EmuTM/LegoRCHub/Model/PCB_Lego_Frame_05x07.SLDPRT

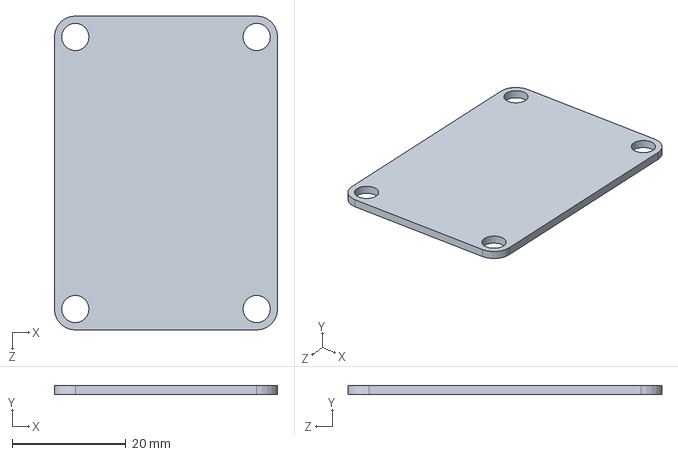
[picture p1: CAD file, 2024-12-19]
Model/PCB_Lego_Frame_05x07.SLDPRT
39.3 x 1.60 x 55.2 mm
