EmuTM/LegoRCHub/PCB/LegoRCHub_10ch/LegoRCHub_10ch.kicad_pcb

## KiCad design PCB/LegoRCHub_10ch/LegoRCHub_10ch.kicad_pcb (2026-02-22)

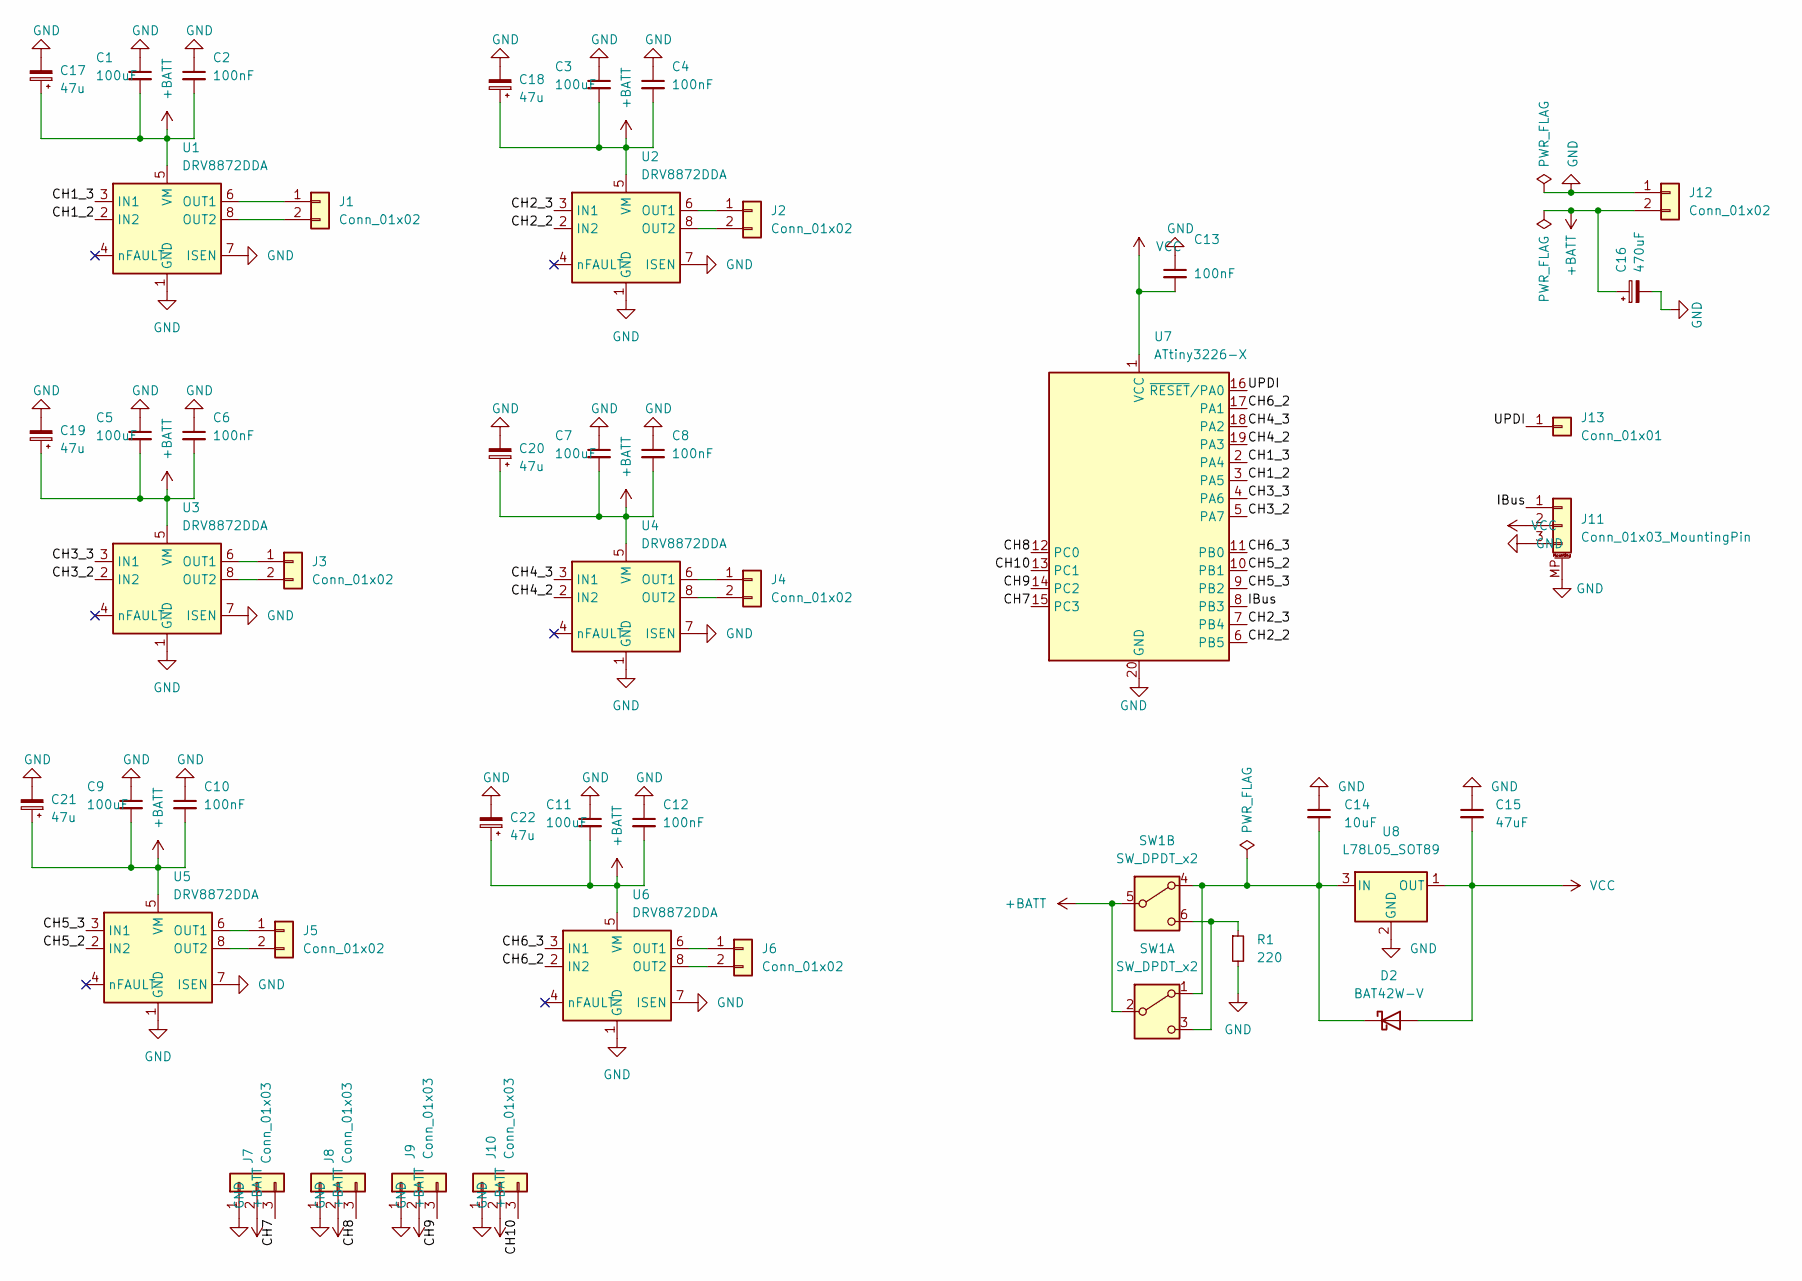
[picture p2: schematic LegoRCHub_10ch.kicad_sch, Lego RC Hub 10ch v7]

Parts:
C1, C3, C5, C7, C9, C11: 100uF; C_1206_3216Metric_Pad1.33x1.80mm_HandSolder
C2, C4, C6, C8, C10, C12: 100nF; C_0805_2012Metric_Pad1.18x1.45mm_HandSolder
C13: 100nF; C_1206_3216Metric_Pad1.33x1.80mm_HandSolder
C14: 10uF; C_0805_2012Metric_Pad1.18x1.45mm_HandSolder
C15: 47uF; C_0805_2012Metric_Pad1.18x1.45mm_HandSolder
C16: 470uF; CP_Elec_8x10.5
C17, C18, C19, C20, C21, C22: 47u; CP_Elec_5x5.4
D2: BAT42W-V; D_SOD-123
J1, J2, J3, J4, J5, J6: Conn_01x02; Molex_KK-254_AE-6410-02A_1x02_P2.54mm_Vertical
J7, J8, J9, J10: Conn_01x03; PinHeader_1x03_P2.54mm_Vertical
J11: Conn_01x03_MountingPin; JST_SH_BM03B-SRSS-TB_1x03-1MP_P1.00mm_Vertical
J12: Conn_01x02; AMASS_XT30U-M_1x02_P5.0mm_Vertical
J13: Conn_01x01; SolderWirePad_1x01_SMD_1x2mm
R1: 220; R_0805_2012Metric_Pad1.20x1.40mm_HandSolder
SW1: SW_DPDT_x2
U1, U2, U3, U4, U5, U6: DRV8872DDA; Texas_HTSOP-8-1EP_3.9x4.9mm_P1.27mm_EP2.95x4.9mm_Mask2.4x3.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
U7: ATtiny3226-X; SSOP-20_5.3x7.2mm_P0.65mm
U8: L78L05_SOT89; SOT-89-3

Connections:
+BATT: C1.2, C2.2, C3.2, C4.2, C5.2, C6.2, C7.2, C8.2, C9.2, C10.2, C11.2, C12.2, C16.1, C17.1, C18.1, C19.1, C20.1, C21.1, C22.1, J7.2, J8.2, J9.2, J10.2, J12.2, SW1.2 (B), SW1.5 (B), U1.5 (VM), U2.5 (VM), U3.5 (VM), U4.5 (VM), U5.5 (VM), U6.5 (VM)
/CH1_2: U1.2 (IN2), U7.3 (PA5)
/CH1_3: U1.3 (IN1), U7.2 (PA4)
/CH2_2: U2.2 (IN2), U7.6 (PB5)
/CH2_3: U2.3 (IN1), U7.7 (PB4)
/CH3_2: U3.2 (IN2), U7.5 (PA7)
/CH3_3: U3.3 (IN1), U7.4 (PA6)
/CH4_2: U4.2 (IN2), U7.19 (PA3)
/CH4_3: U4.3 (IN1), U7.18 (PA2)
/CH5_2: U5.2 (IN2), U7.10 (PB1)
/CH5_3: U5.3 (IN1), U7.9 (PB2)
/CH6_2: U6.2 (IN2), U7.17 (PA1)
/CH6_3: U6.3 (IN1), U7.11 (PB0)
/CH7: J7.3, U7.15 (PC3)
/CH8: J8.3, U7.12 (PC0)
/CH9: J9.3, U7.14 (PC2)
/CH10: J10.3, U7.13 (PC1)
/IBus: J11.1, U7.8 (PB3)
/UPDI: J13.1, U7.16 (~RESET/PA0)
GND: C1.1, C2.1, C3.1, C4.1, C5.1, C6.1, C7.1, C8.1, C9.1, C10.1, C11.1, C12.1, C13.1, C14.1, C15.1, C16.2, C17.2, C18.2, C19.2, C20.2, C21.2, C22.2, J7.1, J8.1, J9.1, J10.1, J11.3, J11.MP (MountPin), J12.1, R1.2, U1.1 (GND), U1.7 (ISEN), U1.9 (GND), U2.1 (GND), U2.7 (ISEN), U2.9 (GND), U3.1 (GND), U3.7 (ISEN), U3.9 (GND), U4.1 (GND), U4.7 (ISEN), U4.9 (GND), U5.1 (GND), U5.7 (ISEN), U5.9 (GND), U6.1 (GND), U6.7 (ISEN), U6.9 (GND), U7.20 (GND), U8.2 (GND)
unnamed: C14.2, D2.1 (K), SW1.1 (A), SW1.4 (A), U8.3 (IN)
unnamed: J1.1, U1.6 (OUT1)
unnamed: J1.2, U1.8 (OUT2)
unnamed: J2.1, U2.6 (OUT1)
unnamed: J2.2, U2.8 (OUT2)
unnamed: J3.1, U3.6 (OUT1)
unnamed: J3.2, U3.8 (OUT2)
unnamed: J4.1, U4.6 (OUT1)
unnamed: J4.2, U4.8 (OUT2)
unnamed: J5.1, U5.6 (OUT1)
unnamed: J5.2, U5.8 (OUT2)
unnamed: J6.1, U6.6 (OUT1)
unnamed: J6.2, U6.8 (OUT2)
unnamed: R1.1, SW1.3 (C), SW1.6 (C)
VCC: C13.2, C15.2, D2.2 (A), J11.2, U7.1 (VCC), U8.1 (OUT)

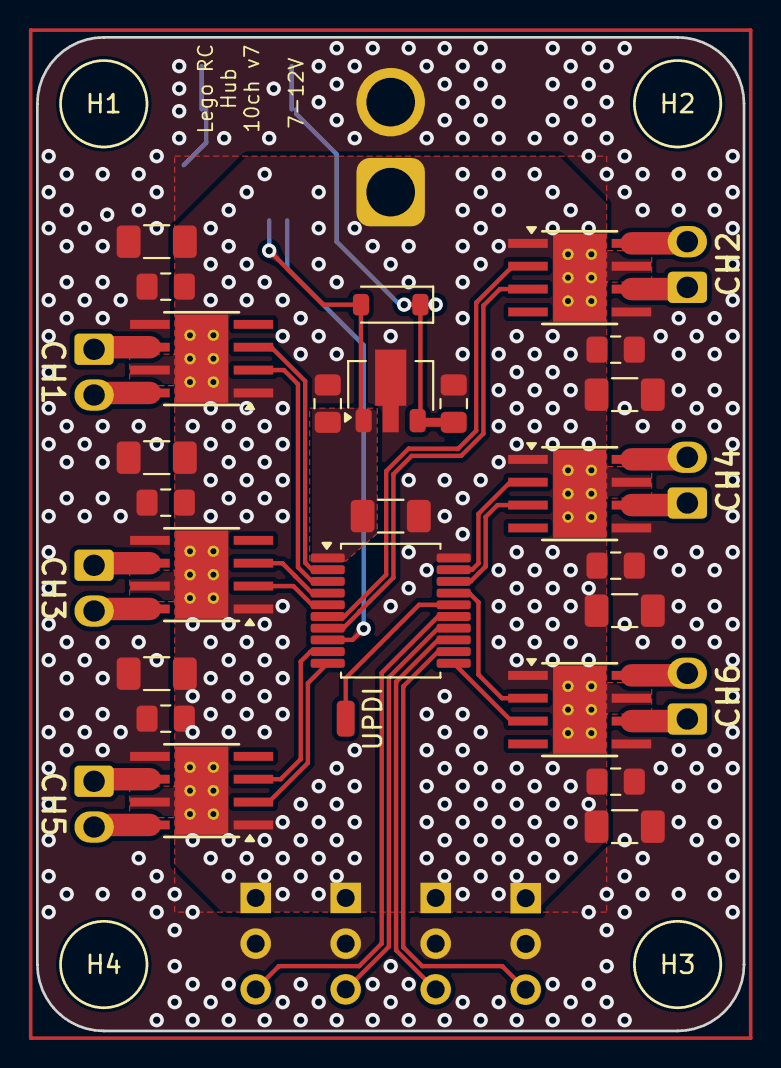
[picture p3: board LegoRCHub_10ch.kicad_pcb from above]

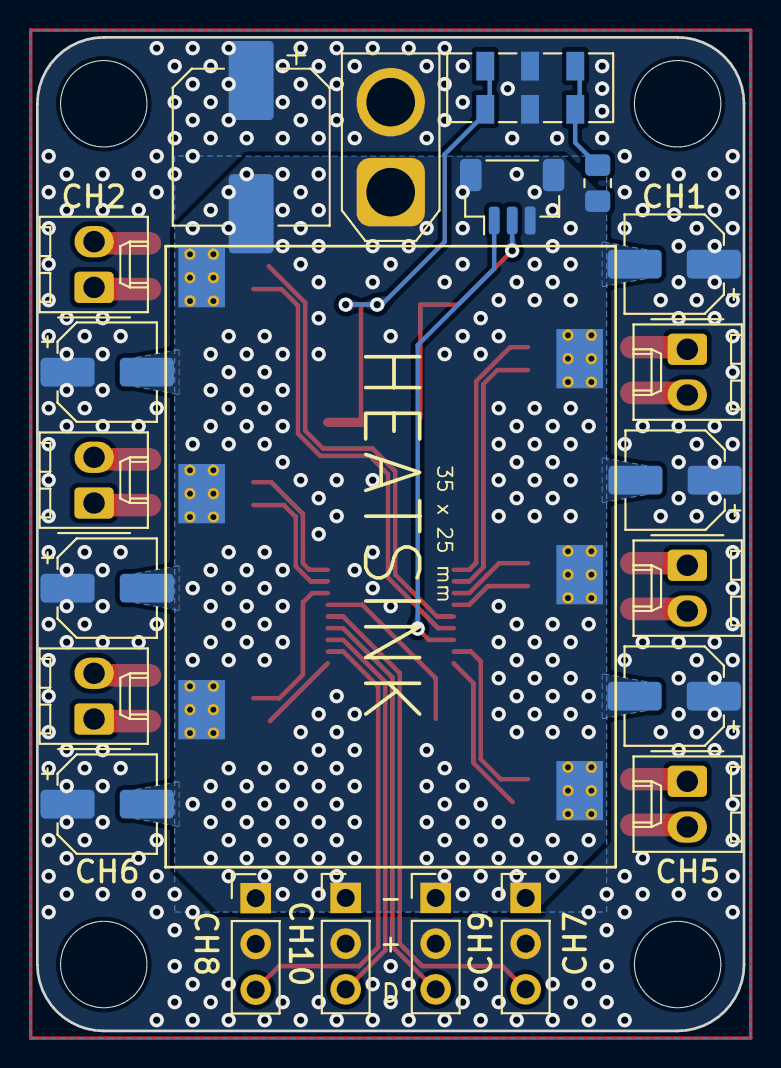
[picture p4: board LegoRCHub_10ch.kicad_pcb from below]

Board: 2 copper layers, 39.3 x 55.2 mm, 50 parts (21 on the bottom side), 35 nets.

Other parts of the board:
H1, H2, H3, H4: MountingHole; MountingHole_4.8mm_Lego
