EmuTM/LegoRCHub/(commit log)

2024-12-19 Added Models together with first model: PCB model for Lego Frame 5x7
    [PCB_Lego_Frame_05x07.SLDPRT]
2024-12-19 Added LegoRCHub_8ch project (KiCad)
    [LegoRCHub_8ch.kicad_pcb, LegoRCHub_8ch.kicad_sch]
2024-12-19 Updated PCB/.gitignore so it ignores ".kicad_prl" files (stores current user settings)
2024-12-19 LegoRCHub_8ch: added schematic
    [LegoRCHub_8ch.kicad_sch]
2024-12-19 PCB: added "CustomFootprints" together with Lego mounting hole (4.8mm)
2024-12-19 LegoRCHub_8ch: working on pcb design...
    [LegoRCHub_8ch.kicad_pcb, LegoRCHub_8ch.kicad_sch]
2024-12-20 LegoRCHub_8ch: finished PCB (beta 1)
    [LegoRCHub_8ch.kicad_pcb, LegoRCHub_8ch.kicad_sch]
2024-12-22 LegoRCHub_8ch: finished PCB (beta 2)
    [LegoRCHub_8ch.kicad_pcb, LegoRCHub_8ch.kicad_sch]
2024-12-22 LegoRCHub_8ch: finished PCB (beta 3)
    [LegoRCHub_8ch.kicad_pcb]
2024-12-23 LegoRCHub_8ch_ServoVoltageConversion: working on pcb design...
    [LegoRCHub_8ch.kicad_pcb]
2024-12-29 LegoRCHub_8ch: finished PCB (beta 4)
    [LegoRCHub_8ch.kicad_pcb, LegoRCHub_8ch.kicad_sch]
2024-12-31 LegoRCHub_8ch: finished PCB (beta 5)
    [LegoRCHub_8ch.kicad_pcb, LegoRCHub_8ch.kicad_sch]
2025-01-02 LegoRCHub_8ch: finished PCB (beta 6)
    [LegoRCHub_8ch.kicad_pcb]
2025-01-02 LegoRCHub_8ch: beta 6: simplified design with 4/4 layout
    [LegoRCHub_8ch.kicad_pcb, LegoRCHub_8ch.kicad_sch]
2025-01-02 LegoRCHub_8ch: beta 7
    [LegoRCHub_8ch.kicad_pcb]
2025-01-04 LegoRCHub_8ch: beta 8 (layout somewhat finished)
    [LegoRCHub_8ch.kicad_pcb, LegoRCHub_8ch.kicad_sch]
2025-01-04 Added project LegoRCHub_10ch: (beta 1)
    [LegoRCHub_10ch.kicad_pcb, LegoRCHub_10ch.kicad_sch]
2025-01-17 Added project LegoRCHub_10ch: (beta 2): changed pins to screw terminals
    [LegoRCHub_10ch.kicad_pcb, LegoRCHub_10ch.kicad_sch]
2025-01-21 LegoRCHub_10ch: ...
    Revert "LegoRCHub_10ch: ..."
    This reverts commit a8209f8826470efcec7313ecef0b47345458ad62.
    [LegoRCHub_10ch.kicad_pcb, LegoRCHub_10ch.kicad_sch]
2025-01-22 LegoRCHub_10ch: ...
    [LegoRCHub_10ch.kicad_pcb, LegoRCHub_10ch.kicad_sch]
2025-01-22 LegoRCHub_10ch: improved design - beta 1
    [LegoRCHub_10ch.kicad_pcb, LegoRCHub_10ch.kicad_sch]
2025-01-23 LegoRCHub_10ch: drv8872s motor traces width decreased to allow for a width increase on isen pin
    [LegoRCHub_10ch.kicad_pcb]
2025-01-23 LegoRCHub_10ch: improved layout...
    [LegoRCHub_10ch.kicad_pcb]
2025-01-24 LegoRCHub_10ch: improved layout: beta-2
    [LegoRCHub_10ch.kicad_pcb]
2025-01-24 LegoRCHub_10ch: improved layout: beta-3
    [LegoRCHub_10ch.kicad_pcb, LegoRCHub_10ch.kicad_sch]
2025-01-25 SW ATTiny3226_10ch: version 1; compliant with pcb design. tested on protoboard; to be tested in real world scenario
2025-02-15 Lego RC Hub 10ch: converted to KiCad8
    [LegoRCHub_10ch.kicad_pcb]
2025-02-15 Lego RC Hub 10ch v2: fully migrated to KiCad8
    [LegoRCHub_10ch.kicad_pcb, LegoRCHub_10ch.kicad_sch]
2025-02-21 Lego RC Hub 10ch v3: improved zones
    [LegoRCHub_10ch.kicad_pcb, LegoRCHub_10ch.kicad_sch]
2025-02-21 Lego RC Hub 10ch: fully migrated to KiCad9
    [LegoRCHub_10ch.kicad_pcb, LegoRCHub_10ch.kicad_sch]
2025-02-21 Lego RC Hub 10ch: v4
    [LegoRCHub_10ch.kicad_pcb, LegoRCHub_10ch.kicad_sch]
2025-02-22 Lego RC Hub 8ch DISCARDED
    [LegoRCHub_8ch.kicad_pcb, LegoRCHub_8ch.kicad_sch]
2025-02-22 Lego RC Hub 10ch: minor tweaking for better rule compliance
    [LegoRCHub_10ch.kicad_pcb, LegoRCHub_10ch.kicad_sch]
2025-02-23 Lego RC Hub 10ch: v5: added additional capacitors on channels + remade all vias
    [LegoRCHub_10ch.kicad_pcb, LegoRCHub_10ch.kicad_sch]
2025-03-01 SW ATTiny3226_10ch v2: added tolerance to ibus channels
    [ATTiny3226_10ch.ino, IBus.cpp, IBus.h]
2025-03-19 SW ATTiny3226_10ch v3: traded PWM resolution for frequency for easier starting of motors
2025-03-31 Increased PWM frequency
2025-03-31 Simplified pin definitions and improved PWM frequency again (3kHz)
2025-05-08 PCB v6: inverted connector (as it should be)
    [LegoRCHub_10ch.kicad_pcb, LegoRCHub_10ch.kicad_sch]
2026-02-22 PCB v7: added switch for microprocessor on/off
    [LegoRCHub_10ch.kicad_pcb, LegoRCHub_10ch.kicad_sch]
